luoTYX/plant-keeper/enclosure/箱体截图.png

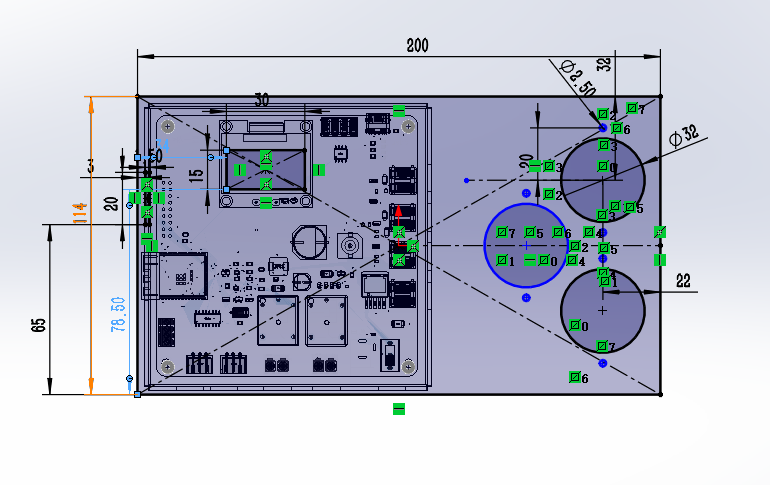
enclosure/箱体截图.png
