luoTYX/plant-keeper/pcb/BOM表.xlsx

No. | Designator | Footprint | Manufacturer | Comment | Quantity | Supplier
1 | BUZZER2 | BUZ-SMD_GSD9605YB-3V2800 | INGHAi(赢海) | 2.7kHz | 1 | LCSC
2 | C3,C4,C6,C8,C9 | C0805 | FH(风华) | 100nF | 5 | LCSC
3 | C5,C7 | C0805 | SAMSUNG(三星) | 10uF | 2 | LCSC
4 | C10 | CAP-SMD_BD12.5-L13.0-W13.0-FD | rubycon(红宝石) | 680uF | 1 | LCSC
5 | C11 | C0805 |  | 100nF | 1
6 | C12 | CAP-SMD_BD6.3-L6.6-W6.6-LS7.2-FD | SAMYOUNG(韩国三莹) | 220uF | 1 | LCSC
7 | CN2,CN3 | CONN-TH_3P-P2.54_HCTL_XH-3AW | HCTL(华灿天禄) | XH-3AW | 2 | LCSC
8 | D1,D2,D5,D6 | SOD-323_L1.8-W1.3-LS2.5-RD | Hottech(合科泰) | 1N5819WS | 4 | LCSC
9 | D3,D4 | SMA_L4.3-W2.5-LS5.0-RD | TWGMC(台湾迪嘉) | 1N4007 | 2 | LCSC
10 | D7 | SMA_L4.4-W2.8-LS5.4-R-RD | MDD(辰达半导体) | SS54 | 1 | LCSC
11 | D8,D9,D10 | SOD-123FL_L2.7-W1.8-LS3.8-RD | R+O(宏嘉诚) | 1N4001W | 3 | LCSC
12 | DC2 | DC-IN-TH_DC-005A-20A | Rectangular Connectors - Contacts | DC-005A-20A | 1 | LCSC
13 | K1,K2 | RELAY-TH_SRD-XXVDC-XL-C | 松乐 | SRD-03VDC-SL-C | 2 | LCSC
14 | L2 | IND-SMD_L7.3-W6.8 | cjiang(长江微电) | 33uH | 1 | LCSC
15 | LED2 | LED0603-RD | 国星光电 | NCD0603Y2 | 1 | LCSC
16 | LED4,LED5 | LED_0805 |  | LED_0805-R | 2
17 | OLED1 | OLED-TH_L35.4-W33.5_HS13L03W2C01 | HS(汉昇) | HS13L03W2C01 | 1 | LCSC
18 | P1,P2,P3,P4 | CONN-TH_2P-P5.00_WJ500V-5.08-2P | KANGNEX(康奈克斯电气) | WJ500V-5.08-2P | 4 | LCSC
19 | Q1,Q6,Q7,Q8 | SOT-23_L2.9-W1.3-P1.90-LS2.4-BR | GOODWORK(固得沃克) | AO3400 | 4 | LCSC
20 | Q2,Q3 | SOT-23-3_L2.9-W1.3-P1.90-LS2.4-BR | CJ(江苏长电/长晶) | SS8050 | 2 | LCSC
21 | Q4,Q5 | SOT-23-3_L2.9-W1.3-P1.90-LS2.3-BR | 宏嘉诚 | S8050 | 2 | LCSC
22 | R1,R2,R7,R8,R9,R10,R11,R12,R13,R14,R15,R24 | R0805 | UNI-ROYAL(厚声) | 1kΩ,4.7kΩ,5.1kΩ,10kΩ,220Ω | 12 | LCSC
23 | R3,R21,R22 | R0805 |  | 4K7,4.3K | 3
24 | R4,R16,R18,R19 | R0603 | UNI-ROYAL(厚声) | 1kΩ | 4 | LCSC
25 | R5,R6,R20,R23 | R0603 | FOJAN(富捷) | 10kΩ | 4 | LCSC
26 | R17 | R0603 |  | 10K | 1
27 | SW1 | Key_SMD_3.6x6.1x2.5 |  | Key_SMD_3.6x6.1x2.5 | 1
28 | SW2 | SW-TH_SS-12D10L3 | XKB Enterprise | SS-12D10L3 | 1 | LCSC
29 | TP1,TP2,TP3,TP4 | M3螺丝 |  | M3螺丝 | 4
30 | U1 | WIRELM-SMD_ESP32-S3-WROOM-1 | ESPRESSIF(乐鑫) | 2.4GHz | 1 | LCSC
31 | U3 | SENSORM-TH_L35.7-W3.9-OV2640 | Waveshare(微雪电子) | OV2640 Camera Board | 1 | LCSC
32 | U4 | SOT-23-5_L3.0-W1.5-P0.95-LS2.8-BL | TECH PUBLIC(台舟) | RT9080-33GJ5 | 1 | LCSC
33 | U5 | TO-263-5_L10.2-W8.9-P1.70-TL | TI(德州仪器) | LM2596SX-5.0/NOPB | 1 | LCSC
34 | U6 | CONN-TH_DB125-2.54-4P-GN | DORABO(地博电气) | DB125-2.54-4P-GN-S | 1 | LCSC
35 | U7 | CONN-TH_DB125-3.5-4P-GN | DORABO(地博电气) | DB125-3.5-4P-GN-S | 1 | LCSC
36 | U8 | SOP-16_L10.0-W3.9-P1.27-LS6.0-BL | WCH(南京沁恒) | CH340C | 1 | LCSC
37 | U9 | SOP-8_L5.0-W4.0-P1.27-LS6.0-BL | UMW(友台半导体) | MAX485ESA(UMW) | 1 | LCSC
38 | U11,U12 | CONN-TH_P5.00_KF301-5.0-2P | KEFA(科发) | KF301-5.0-2P | 2 | LCSC
39 | USBC1 | USB-C_SMD-TYPE-C-31-M-12 | 韩国韩荣 | TYPE-C-31-M-12 | 1 | LCSC
