luoTYX/plant-keeper/pcb/SCH_Schematic1_2026-06-21.pdf

# 5v降压

水泵

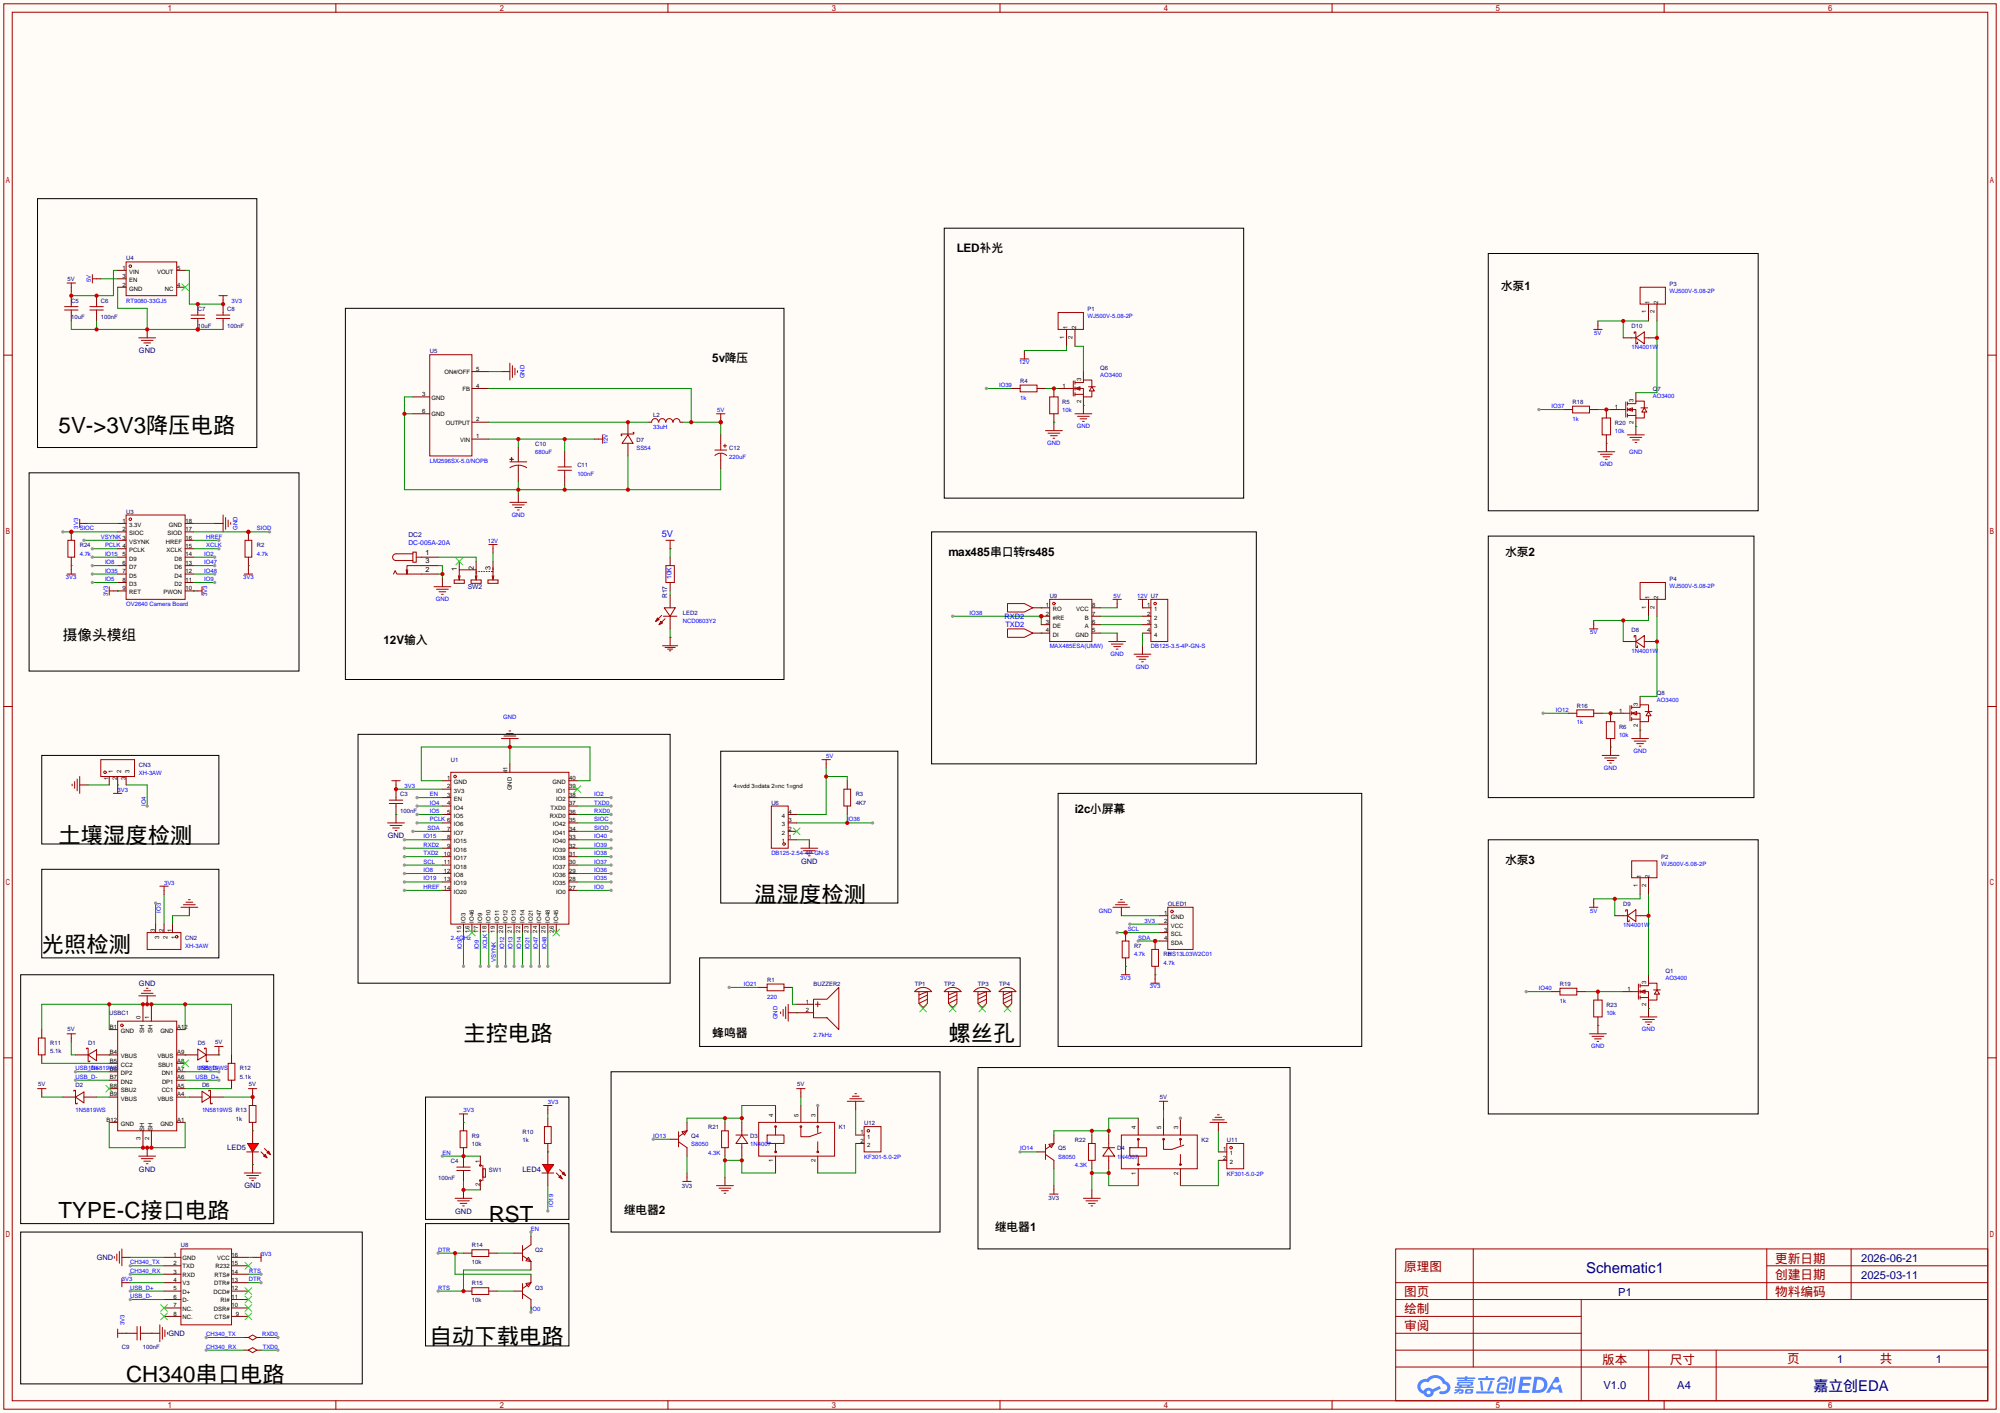
[picture p2: page 1]

4=vdd 3=data 2=nc 1=gnd
