luoTYX/plant-keeper/(list of files, drawings)

Other design files:
pcb/基于ESP32智能动植物养护调控系统_2026-06-21.epro
