luoTYX/plant-keeper/(commit log)

2026-06-21 比赛赶工10天的智能植物养护系统，先开源再说
    [BOM表.xlsx, 基于ESP32智能动植物养护调控系统_2026-06-21.epro]
2026-06-21 基于ESP32-S3的智能植物养护系统
    [BOM表.xlsx, 基于ESP32智能动植物养护调控系统_2026-06-21.epro]
2026-06-21 更新固件代码
